Joerg-66/ESP8266-WebMonitor/Quick & Easy/WebMonitor_1_Easy_Schematic.jpg

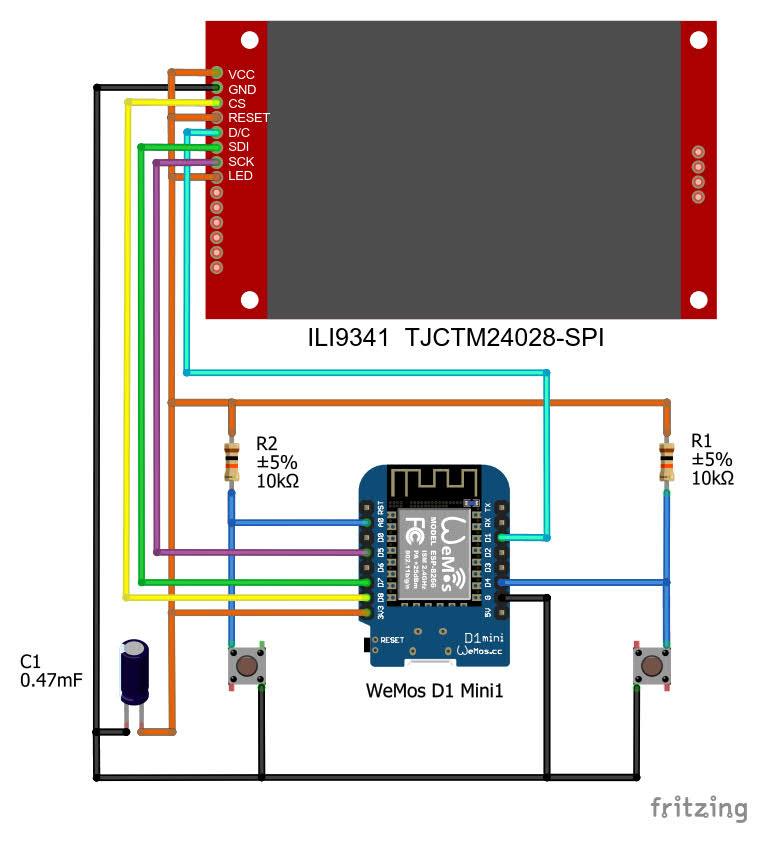
Quick & Easy/WebMonitor_1_Easy_Schematic.jpg
