Joerg-66/ESP8266-WebMonitor/Hardware/WebMonitor_1_BOM.pdf

Position | Name
1 | C1 | 100µF | G1206 | X5R-G1206 100/6 | 0,27 €
2 | C2 | 100µF | G1207 | X5R-G1206 100/7 | 0,27 €
3 | C3 | 100µF | G1208 | X5R-G1206 100/8 | 0,27 €
4 | C4 | 100µF | G1209 | X5R-G1206 100/9 | 0,27 €
5 | C5 | 100nF | G1210 | X7R-G1206 100N | 0,10 €
6 | D1 | ROT | 1206-D | LED EL 1206 RT | 0,10 €
7 | D2 | GRÜN | 1206-D | LED EL 1206 GR2 | 0,12 €
8 | Display1 TJCTM24028-SPI TJCTM24028 | 2,8" TFT LCD Display Modul ILI9341 240x320 | 17,93 €
9 | IC1 | | | CP18015 | 9,05 €
10 | K1 | TYPE-C-31-M-17 TYPEC31M17 | TYPE-C-31-M-17
11 | K2 | TYPE-C-31-M-17 TYPEC31M17 | TYPE-C-31-M-17
12 | K3 | DX4R005J91 | JAE_DX4R005J91 | DX4R005J
13 | K4 | C8320-05BFRIB0R C8320-05BFRIB0R | USB BWM | 0,48 €
14 | R1 | 10k | 1206 | SMD 1/4W 10K | 0,04 €
15 | R2 | 10k | 1206 | SMD 1/4W 10K | 0,04 €
16 | R3 | 10k | 1206 | SMD 1/4W 10K | 0,04 €
17 | R4 | 10k | 1206 | SMD 1/4W 10K | 0,04 €
18 | R5 | 1k | 1206 | SMD 1/4W 1,0K | 0,04 €
19 | R6 | 1k | 1206 | SMD 1/4W 1,0K | 0,04 €
20 | S1 | JTP-1236A | TACT_JTP-1236A | TASTER 3305B | 0,18 €
21 | S2 | JTP-1236A | TACT_JTP-1236A | TASTER 3305B | 0,18 €
Value | Housing | Supplier (Proposal only) Ordering Information (Status of 08/2021) | Price (08/2021)
| | www.Reichelt.de www.Reichelt.de www.Reichelt.de www.Reichelt.de www.Reichelt.de www.Reichelt.de www.Reichelt.de www.roboter-bausatz.de
Wemos_D1_mini Wemos_D1 | www.eckstein-shop.de
| | Korean Hroparts Elec Korean Hroparts Elec JAE Electronics www.Reichelt.de www.Reichelt.de www.Reichelt.de www.Reichelt.de www.Reichelt.de www.Reichelt.de www.Reichelt.de www.Reichelt.de www.Reichelt.de
