Joerg-66/ESP8266-WebMonitor/Hardware/WebMonitor_1_Schematic.pdf

## USB-C

## TYPE-C-31-M-17

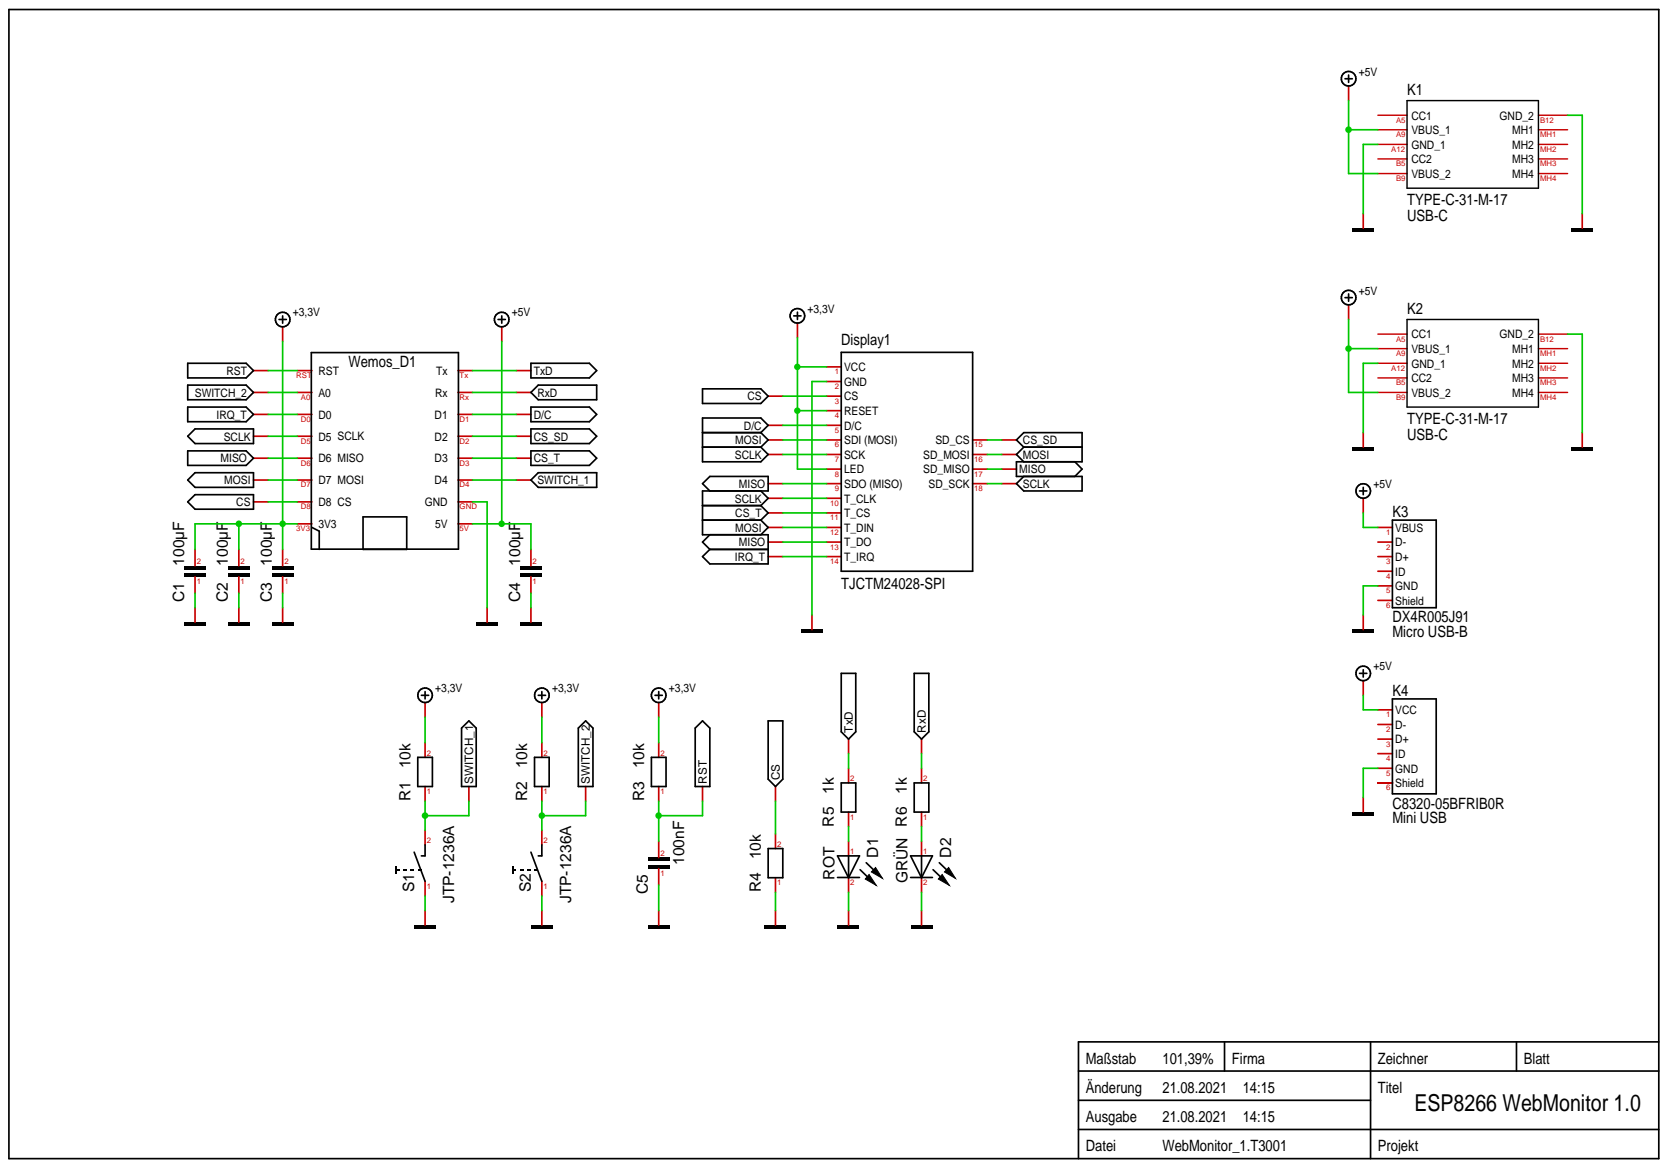
[picture p2: page 1]

Maßstab 101,39% | Firma | Zeichner | Blatt
Änderung 21.08.2021 14:15 | | Titel ESP8266 WebMonitor 1.0
