Joerg-66/ESP8266-WebMonitor/Software/WebMonitor_1-3/ILI9341_Graphic.cpp

/*
 * Ansteuerung eines Displays mit ILI9341-Controller und vorgefertigten Bildern zur Visualisierung
 * 
 * Autor: Jörg Bernhardt
 * Datum 11/2020
 * 
 * wichtige Links:
 * Bilder generieren:  https://javl.github.io/image2cpp/
 * 
 */
 
#include "ILI9341_Graphic.h"


ILI9341_Graphic::ILI9341_Graphic(uint8_t CS, uint8_t RS, uint8_t RST) : Adafruit_ILI9341(CS, RS, RST)
{
  // as we already know the orientation (landscape, therefore rotated),
  // set default width and height without need to call begin() first.
  _width = 320;
  _height = 240;
}

void ILI9341_Graphic::Setup()
{
  setRotation(3);
  fillScreen(ILI9341_BLACK);
}


void ILI9341_Graphic::TextBits(int xPos, int yPos, long lValue, uint16_t u16Color)
{
  String sText;
  float  fValue;
  char   sBuf[6];
  
  lValue = abs(lValue);
  if(lValue > 999999){                                  // wenn Wert > 999 MBit/s
    fValue = (float)lValue / 1000000;
    if(fValue < 10) dtostrf(fValue, 4, 2, sBuf);        // 1 Vorkommazeichen + "Punkt" + 2 Nachkommazeichen + '\0' = 6 Array-Felder
    else if(fValue < 100) dtostrf(fValue, 3, 0, sBuf);  // 2 Vorkommazeichen + 0 Nachkommazeichen + '\0' = 5 Array-Felder
    else dtostrf(fValue, 3, 0, sBuf);                   // 3 Vorkommazeichen + 0 Nachkommazeichen + '\0' = 5 Array-Felder
    sBuf[5] = '\0';
    sText = String(sBuf);
    sText.replace(".", ",");
    sText.trim();
  }
  else if(lValue > 999){                          // wenn Wert > 999 kBit/s
    fValue = (float)lValue / 1000;
    if(fValue < 10) dtostrf(fValue, 4, 2, sBuf);        // 1 Vorkommazeichen + "Punkt" + 2 Nachkommazeichen + '\0' = 6 Array-Felder
    else if(fValue < 100) dtostrf(fValue, 3, 0, sBuf);  // 2 Vorkommazeichen + 0 Nachkommazeichen + '\0' = 5 Array-Felder
    else dtostrf(fValue, 3, 0, sBuf);                   // 3 Vorkommazeichen + 0 Nachkommazeichen + '\0' = 5 Array-Felder
    sBuf[5] = '\0';
    sText = String(sBuf);
    sText.replace(".", ",");
    sText.trim();
  }
  else sText = String(lValue);                          // wenn Wert < 1000 kBit/s
  
  while(sText.length() < 4) sText = " " + sText;        // Links mit Leerzeichen auffüllen zur rechtbündige Ausrichtung
  setCursor(xPos, yPos);
  setTextSize(1);
  setTextColor(u16Color, ILI9341_BLACK);
  print(sText);

  if(lValue > 999999) sText = "G";              // wenn Wert > 999999 = Gbit/s
  else if(lValue > 999) sText = "M";            // wenn Wert > 999 = Mbit/s
  else sText = "K";                             // wenn Wert < 1000 = Bit/s
  setCursor(xPos+27, yPos);
  print(sText);
}


/*  Der Farbwert besteht aus 5 Bit (0..31) für die Farben Rot und Blau sowie 6 Bit (0...63) füe die Farbe Grün.
* Zur Vereinfachung werden dieser Funktion jeweils gültige Farbwerte von 0...255 übergeben.
* Diese werden in den gültigen Wertebereich umgerechnet und in den 16-Bit Wert geschrieben: uint16_t (RRRRRGGGGGGBBBBB) 
*/
uint16_t ILI9341_Graphic::getColorValue(byte bRed, byte bGreen, byte bBlue)
{
  uint16_t iRed;
  uint16_t iGreen;
  uint16_t iBlue;

  iRed = bRed & B11111000;
  iRed = iRed << 8;
  iGreen = bGreen & B11111000;
  iGreen = iGreen << 3;
  iBlue = bBlue & B11111000;
  iBlue = iBlue >> 3;
  return (iRed | iGreen | iBlue);
}


void ILI9341_Graphic::Connection(int xPos, int yPos, boolean bStatus)
{
  static boolean blnDirection = false;  
  static byte bPosition = 0;
  byte bOldPosition;
  uint16_t iColor;
  
  if(bStatus==false){
    fillCircle(xPos + bPosition, yPos, 4, ILI9341_BLACK);
    drawLine(xPos, yPos, xPos+80, yPos, ILI9341_BLACK);
  }
  if(bStatus==true){
    bOldPosition = bPosition;
    if(blnDirection == true){
      iColor = ILI9341_GREEN;
      bPosition = bPosition -5;
      if(bPosition < 7) blnDirection = false;
    }
    else {
      iColor = ILI9341_CYAN;
      bPosition = bPosition + 5;
      if(bPosition > 73) blnDirection = true;
    }
    fillCircle(xPos + bOldPosition, yPos, 4, ILI9341_BLACK);
    fillCircle(xPos + bPosition, yPos, 4, iColor);
    drawLine(xPos, yPos, xPos+80, yPos, iColor);
  }
}


void ILI9341_Graphic::Grid_01(int xPos, int yPos, long currentValue, long maxValue, uint16_t barColor)
{
  static long arrayValue[226];
  static int iOldValue;  
  int iValue;
  int iBlack;
  int iStepwidth; 
  
  if(maxValue==0){
    iOldValue = 0;
    for(int i=0; i<226; i++){
      arrayValue[i] = 0;
    }
    return;
  }

  for(int i=220; i>0; i--)  arrayValue[i+5] = arrayValue[i];

  if(currentValue>maxValue) currentValue = maxValue;
  iValue = int(74 * currentValue / maxValue);

  iStepwidth = iOldValue - iValue;
  iStepwidth = int(iStepwidth / 4);
  arrayValue[1] = iValue;
  arrayValue[2] = iStepwidth + iValue;
  arrayValue[3] = (iStepwidth * 2) + iValue;
  arrayValue[4] = (iStepwidth * 3) + iValue;
  arrayValue[5] = iOldValue;

  iOldValue = iValue;

  drawRect(xPos, yPos, 226, 76, ILI9341_WHITE);
  for(int i=1; i<225; i++){
    if(i%15==0) drawFastVLine(xPos + i, yPos + 1, 74, ILI9341_DARKGREY);
    else{
      iValue = arrayValue[i];
      if(iValue<1) iValue = 1;
      iBlack = 74 - iValue;
      drawFastVLine(xPos + i, yPos + 1 + iBlack, iValue, barColor);
      drawFastVLine(xPos + i, yPos + 1, iBlack, ILI9341_BLACK);
      drawPixel(xPos + i, yPos + 15, ILI9341_DARKGREY);
      drawPixel(xPos + i, yPos + 30, ILI9341_DARKGREY);
      drawPixel(xPos + i, yPos + 45, ILI9341_DARKGREY);
      drawPixel(xPos + i, yPos + 60, ILI9341_DARKGREY);
    } 
  }
}

void ILI9341_Graphic::Grid_02(int xPos, int yPos, long currentValue, long maxValue, uint16_t barColor)
{
  static long arrayValue[226];
  static int iOldValue;  
  int iValue;
  int iBlack;
  int iStepwidth; 
  
  if(maxValue==0){
    iOldValue = 0;
    for(int i=0; i<226; i++){
      arrayValue[i] = 0;
    }
    return;
  }

  for(int i=220; i>0; i--)  arrayValue[i+5] = arrayValue[i];

  if(currentValue>maxValue) currentValue = maxValue;
  iValue = int(74 * currentValue / maxValue);

  iStepwidth = iOldValue - iValue;
  iStepwidth = int(iStepwidth / 4);
  arrayValue[1] = iValue;
  arrayValue[2] = iStepwidth + iValue;
  arrayValue[3] = (iStepwidth * 2) + iValue;
  arrayValue[4] = (iStepwidth * 3) + iValue;
  arrayValue[5] = iOldValue;

  iOldValue = iValue;

  drawRect(xPos, yPos, 226, 76, ILI9341_WHITE);
  for(int i=1; i<225; i++){
    if(i%15==0) drawFastVLine(xPos + i, yPos + 1, 74, ILI9341_DARKGREY);
    else{
      iValue = arrayValue[i];
      if(iValue<1) iValue = 1;
      iBlack = 74 - iValue;
      drawFastVLine(xPos + i, yPos + 1 + iBlack, iValue, barColor);
      drawFastVLine(xPos + i, yPos + 1, iBlack, ILI9341_BLACK);
      drawPixel(xPos + i, yPos + 15, ILI9341_DARKGREY);
      drawPixel(xPos + i, yPos + 30, ILI9341_DARKGREY);
      drawPixel(xPos + i, yPos + 45, ILI9341_DARKGREY);
      drawPixel(xPos + i, yPos + 60, ILI9341_DARKGREY);
    } 
  }
}

void ILI9341_Graphic::Wifi(int xPos, int yPos, uint16_t u16Color, String sDbValue)
{
  // 'WiFi', 31x22px
  const uint8_t bitmap[] = {
    0x00, 0x00, 0x00, 0x00, 0x00, 0x1f, 0xf0, 0x00, 0x00, 0xff, 0xfe, 0x00, 0x01, 0xff, 0xff, 0x80, 
    0x07, 0xe0, 0x0f, 0xc0, 0x0f, 0x00, 0x01, 0xe0, 0x1e, 0x00, 0x00, 0xf0, 0x3c, 0x07, 0xc0, 0x78, 
    0x78, 0x1f, 0xf0, 0x3c, 0x70, 0x7e, 0xfc, 0x1c, 0x20, 0xf0, 0x1e, 0x08, 0x01, 0xe0, 0x0f, 0x00, 
    0x03, 0xc0, 0x07, 0x80, 0x03, 0x80, 0x03, 0x80, 0x01, 0x03, 0x81, 0x00, 0x00, 0x07, 0xc0, 0x00, 
    0x00, 0x0f, 0xe0, 0x00, 0x00, 0x0f, 0xe0, 0x00, 0x00, 0x0f, 0xe0, 0x00, 0x00, 0x07, 0xc0, 0x00, 
    0x00, 0x03, 0x80, 0x00, 0x00, 0x00, 0x00, 0x00
  };
  drawBitmap(xPos, yPos, bitmap, 31, 22, u16Color);
  if(sDbValue.length() > 0){
    setTextColor(ILI9341_WHITE, ILI9341_BLACK);
    setTextSize(1);
    setCursor(xPos + 25, yPos + 22);
    print(sDbValue + "dBm");
  }
  else{
    fillRect(xPos + 24, yPos + 21, 43, 10, ILI9341_BLACK);
  }
}

void ILI9341_Graphic::Cloud(int xPos, int yPos, uint16_t u16Color)
{
  // 'Cloud', 32x20px
  const uint8_t bitmap[] = {
    0x00, 0x00, 0x00, 0x00, 0x00, 0x07, 0xc0, 0x00, 0x00, 0x1e, 0x78, 0x00, 0x00, 0x30, 0x1c, 0x00, 
    0x00, 0x60, 0x0e, 0x00, 0x00, 0xc0, 0x06, 0x00, 0x00, 0xc0, 0x07, 0xe0, 0x01, 0x80, 0x0e, 0x78, 
    0x0f, 0xc0, 0x18, 0x1c, 0x1c, 0x00, 0x10, 0x0c, 0x30, 0x00, 0x00, 0x06, 0x20, 0x00, 0x00, 0x06, 
    0x60, 0x00, 0x00, 0x02, 0x60, 0x00, 0x00, 0x06, 0x60, 0x00, 0x00, 0x0e, 0x30, 0x00, 0x00, 0x0c, 
    0x38, 0x00, 0x00, 0x18, 0x1f, 0xff, 0xff, 0xf0, 0x07, 0xff, 0xff, 0xe0, 0x00, 0x00, 0x00, 0x00
  };
  drawBitmap(xPos, yPos, bitmap, 32, 20, u16Color);
}

void ILI9341_Graphic::Computer(int xPos, int yPos, uint16_t u16Color)
{
  // 'Computer', 32x25px
  const uint8_t bitmap[] = {
    0x00, 0x00, 0x00, 0x00, 0x3f, 0xff, 0xff, 0xfc, 0x7f, 0xff, 0xff, 0xfe, 0x60, 0x00, 0x00, 0x06, 
    0x60, 0x00, 0x00, 0x06, 0x60, 0x00, 0x00, 0x06, 0x60, 0x38, 0x08, 0x06, 0x60, 0x7c, 0x0c, 0x06, 
    0x60, 0xc4, 0xc4, 0x06, 0x60, 0xc0, 0xc6, 0x06, 0x60, 0xc0, 0x02, 0x06, 0x60, 0xc0, 0x03, 0x06, 
    0x60, 0xc4, 0xc1, 0x06, 0x60, 0x7c, 0xc1, 0x86, 0x60, 0x38, 0x00, 0x86, 0x60, 0x00, 0x00, 0x06, 
    0x60, 0x00, 0x00, 0x06, 0x60, 0x00, 0x00, 0x06, 0x7f, 0xff, 0xff, 0xfe, 0x3f, 0xff, 0xff, 0xfc, 
    0x00, 0x00, 0x00, 0x00, 0x00, 0x3f, 0xfc, 0x00, 0x00, 0x7f, 0xfe, 0x00, 0x00, 0x7f, 0xfe, 0x00, 
    0x00, 0x00, 0x00, 0x00
  };
  drawBitmap(xPos, yPos, bitmap, 32, 25, u16Color);
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
    0xff, 0x00, 0x00, 0x00, 0x00, 0x00, 0x07, 0xff, 0xff, 0xff, 0xff, 0xff, 0xff, 0xff, 0x00, 0x00, 
    0x00, 0x00, 0x00, 0x07, 0xc7, 0xf7, 0xff, 0xff, 0xff, 0xff, 0xf1, 0x00, 0x00, 0x00, 0x00, 0x00, 
    0x03, 0x81, 0xf3, 0xc1, 0xe0, 0xe0, 0x03, 0xc0, 0x00, 0x00, 0x00, 0x00, 0x00, 0x03, 0x00, 0xf1, 
    0xc1, 0xe0, 0xe0, 0x03, 0x80, 0x00, 0x00, 0x00, 0x00, 0x00, 0x02, 0x00, 0xf0, 0xc0, 0xe0, 0x60, 
    0x01, 0x80, 0x00, 0x00, 0x00, 0x00, 0x00, 0x02, 0x00, 0x70, 0x40, 0xe0, 0x60, 0x01, 0x80, 0x00, 
    0x00, 0x00, 0x00, 0x00, 0x02, 0x00, 0x70, 0x00, 0xe0, 0x70, 0x01, 0x00, 0x00, 0x00, 0x00, 0x00, 
    0x00, 0x00, 0x00, 0x70, 0x00, 0xe0, 0x70, 0x01, 0x00, 0x00, 0x00, 0x00, 0x00, 0x00, 0x00, 0x00, 
    0x30, 0x00, 0xe0, 0x7c, 0x01, 0x00, 0x00, 0x00, 0x00, 0x00, 0x00, 0x00, 0x00, 0x30, 0x00, 0xe0, 
    0x7c, 0x0f, 0x00, 0x00, 0x00, 0x00, 0x00, 0x00, 0x00, 0x00, 0x30, 0x00, 0xe0, 0x7c, 0x0f, 0x00, 
    0x00, 0x00, 0x00, 0x00, 0x00, 0x00, 0x00, 0x30, 0x00, 0xe0, 0x7c, 0x0f, 0x00, 0x00, 0x00, 0x00, 
    0x00, 0x00, 0x00, 0x00, 0x30, 0x00, 0xe0, 0x7c, 0x0f, 0x00, 0x00, 0x00, 0x00, 0x00, 0x00, 0x00, 
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
  };
  drawBitmap(xPos + 10, yPos + 10, bitmapBlue, 100, 67, ILI9341_BLUE);
}

void ILI9341_Graphic::MessageScreen_01(String sIP_Address)
{
  int iPosX = 10;
  int iPosY = 20;

  fillScreen(ILI9341_BLACK);
  Logo(190,10);
  setTextSize(1);
  setTextColor(ILI9341_WHITE);
  setCursor(iPosX, iPosY);
  println("Der Router ist noch nicht");
  iPosY = iPosY + 15; setCursor(iPosX, iPosY);
  println("konfiguriert. Zur");
  iPosY = iPosY + 15; setCursor(iPosX, iPosY);
  println("Konfiguration einen Computer");
  iPosY = iPosY + 15; setCursor(iPosX, iPosY);
  println("mit dem WLAN \"Web_Monitor\"");
  iPosY = iPosY + 15; setCursor(iPosX, iPosY);
  println("verbinden und die Website");
  iPosY = iPosY + 15; setCursor(iPosX, iPosY);
  println("http:\/\/" + sIP_Address + "\/index.html");
  iPosY = iPosY + 15; setCursor(iPosX, iPosY);
  println("mit einem Browser \224ffnen.");
  iPosY = iPosY + 15; setCursor(iPosX, iPosY);
  println("Die Konfigurationswerte eintragen und auf den");
  iPosY = iPosY + 15; setCursor(iPosX, iPosY);
  println("Button \"Alle Werte \201bernehmen\" klicken.");
  iPosY = iPosY + 15; setCursor(iPosX, iPosY);
  println("Danach den Router neu starten.");
  iPosY = iPosY = iPosY + 30; setCursor(iPosX, iPosY);
  setTextColor(ILI9341_YELLOW);
  println("ACHTUNG: Unbedingt auch die auf der Website");
  iPosY = iPosY + 15; setCursor(iPosX, iPosY);
  println("beschriebenen Einstellungen f\201r die TR-064");
  iPosY = iPosY + 15; setCursor(iPosX, iPosY);
  println("Kommunikation im Router vornehmen.");
}

void ILI9341_Graphic::MessageScreen_02(String sWifiSSID, String sWifiPassword, String sTR064_User, String sTR064_Password, String sMaxDL_Speed, String sMaxUL_Speed)
{
  int iPosX = 10;
  int iPosY = 20;

  fillScreen(ILI9341_BLACK);
  Logo(190,10);
  setTextSize(1);
  setTextColor(ILI9341_WHITE);
  setCursor(iPosX, iPosY);
  println("WLAN Name:");
  iPosY = iPosY + 15; setCursor(iPosX, iPosY);
  println("   \"" + sWifiSSID + "\"");
  iPosY = iPosY + 20;setCursor(iPosX, iPosY);
  println("WLAN Passwort:");
  iPosY = iPosY + 15; setCursor(iPosX, iPosY);
  println("   \"" + sWifiPassword + "\"");
  iPosY = iPosY + 20; setCursor(iPosX, iPosY);
  println("TR-064 User:");
  iPosY = iPosY + 15; setCursor(iPosX, iPosY);
  println("   \"" + sTR064_User + "\"");
  iPosY = iPosY + 20; setCursor(iPosX, iPosY);
  println("TR-064 Passwort:");
  iPosY = iPosY + 15; setCursor(iPosX, iPosY);
  println("   \"" + sTR064_Password + "\"");
  iPosY = iPosY + 20; setCursor(iPosX, iPosY);
  println("Download Speed - Upload Speed:");    
  iPosY = iPosY + 15; setCursor(iPosX, iPosY);      
  print("   " + sMaxDL_Speed + " MBit/s - ");      
  println(sMaxUL_Speed + " MBit/s");    
  setTextColor(ILI9341_CYAN);
  iPosY = iPosY + 20; setCursor(iPosX, iPosY);
  println("Jetzt den Web-Monitor neu starten.");
  iPosY = iPosY + 15; setCursor(iPosX, iPosY);
  println("Dazu einen Taster dr\201cken oder die Spannungs-");
  iPosY = iPosY + 15; setCursor(iPosX, iPosY);
  println("versorgung kurz trennen und wieder verbinden.");
}

void ILI9341_Graphic::MessageScreen_03(void)
{
  int iPosX = 10;
  int iPosY = 110;

  fillScreen(ILI9341_BLACK);
  Logo(190,0);
  setTextSize(2);
  setTextColor(ILI9341_WHITE);
  setCursor(iPosX, iPosY);
  println("Die Taste ca. 8 Sekunden");
  iPosY = iPosY + 25; setCursor(iPosX, iPosY);
  println("gedr\201ckt halten, um");
  iPosY = iPosY + 25; setCursor(iPosX, iPosY);
  println("die existierende");
  iPosY = iPosY + 25; setCursor(iPosX, iPosY);
  println("Konfiguration zu l\224schen.");
}

void ILI9341_Graphic::MessageScreen_04(void)
{
  int iPosX = 10;
  int iPosY = 100;

  fillScreen(ILI9341_BLACK);
  Logo(190,0);
  setTextSize(2);
  setTextColor(ILI9341_RED);
  setCursor(iPosX, iPosY);
  println("Die Konfiguration wurde");
  iPosY = iPosY + 25; setCursor(iPosX, iPosY);
  println("vollst\204ndig gel\224scht!");
  setTextColor(ILI9341_WHITE);
  iPosY = iPosY + 50; setCursor(iPosX, iPosY);
  println("In wenigen Sekunden wird");
  iPosY = iPosY + 25; setCursor(iPosX, iPosY);
  println("ein Neustart durchgef\201hrt");
}
