Joerg-66/ESP8266-WebMonitor/Software/WebMonitor_1-3/ESP_Settings.h

/*
 * Website für Nutzereinstellungen inklusive Speicherung im EEPROM
 * 
 * Autor: Jörg Bernhardt
 * Datum 11/2020
 * 
 * wichtige Links:
 * https://arduino-esp8266.readthedocs.io/en/latest/esp8266wifi/server-examples.html
 * “Encode image to Base64” --> https://base64.guru/converter/encode/image
 * 
 */

#ifndef ESP_Settings_h
#define ESP_Settings_h

#include <Arduino.h>
#include <ESP8266WiFi.h>

class ESP_Settings
{
  public:
    void WebInterface(boolean bShowFullSite);
    String Read_WifiSSID(void);                                   //gespeicherte Wifi SSID aus dem EEPROM auslesen
    String Read_WifiPassword(void);                               //gespeichertes Wifi Passwort aus dem EEPROM auslesen
    String Read_TR064_User(void);                                 //gespeicherten TR-064 User aus dem EEPROM auslesen
    String Read_TR064_Password(void);                             //gespeichertes TR-064 Passwort aus dem EEPROM auslesen
    unsigned long Read_Download_Speed(void);                      //gespeichertes max. Download Geschwindigkeit aus dem EEPROM auslesen
    unsigned long Read_Upload_Speed(void);                        //gespeichertes max. Upload Geschwindigkeit aus dem EEPROM auslesen
    void DeleteEEPROM(void);                                      //alle EEPROM Daten löschen
    
  private:
    boolean HTML_noSpecialChar(String HTML2test);
    String HTML_RemoveSpecialChar(String HTML2test);
    String UTF8toASCII(String sUTF8);
    String ASCIItoUTF8(String ASCII_String);
    String PickValue(String HTML_String, String Search_String);
    void WriteEEPROM(void);
        
};

#endif
